Rezero0x00/Aero-Pendulum/Documentation/Hardware.jpeg

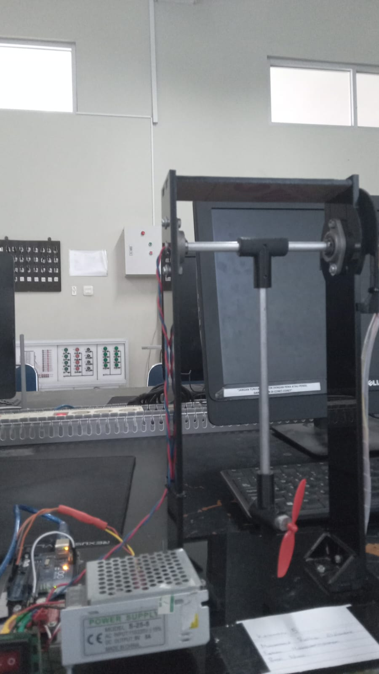
Documentation/Hardware.jpeg
