Rezero0x00/Aero-Pendulum/Documentation/3d-3.jpg

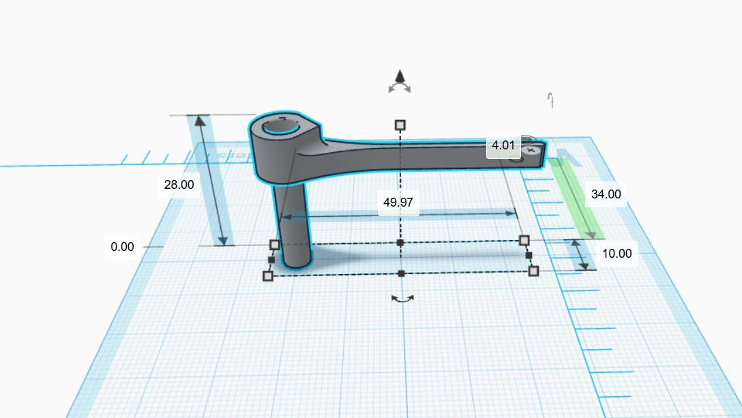
Documentation/3d-3.jpg
