Rezero0x00/Aero-Pendulum/Documentation/45.png

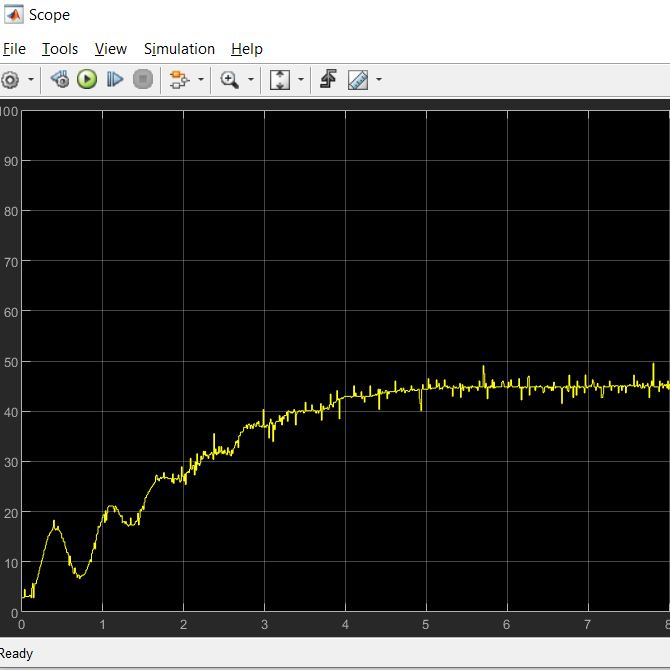
Documentation/45.png
