Rezero0x00/Aero-Pendulum/Documentation/60.png

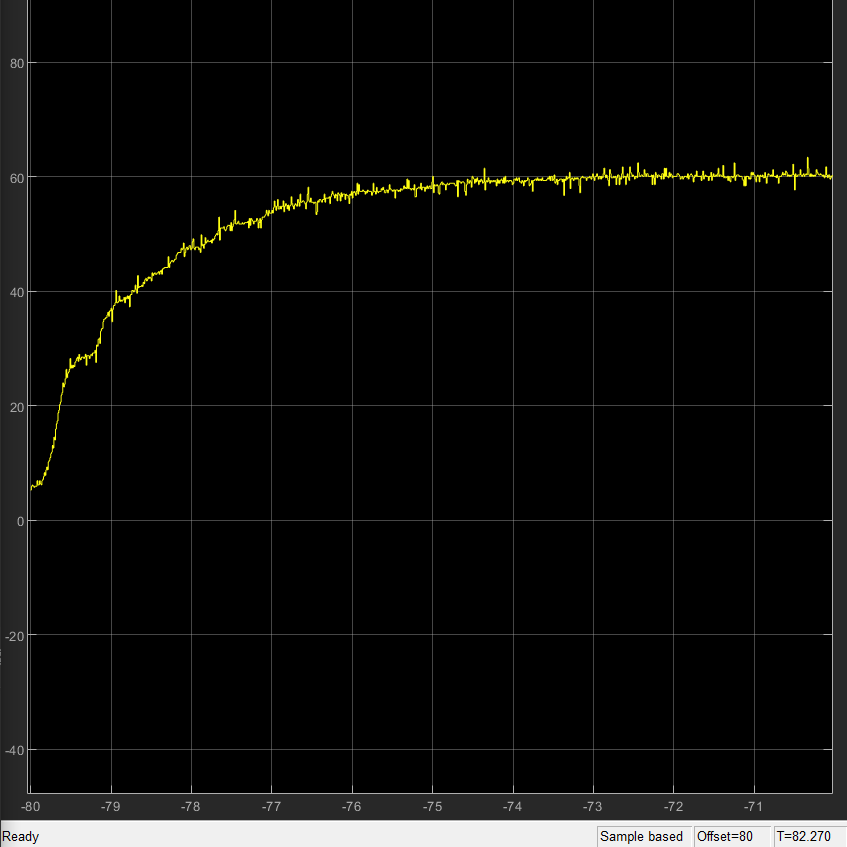
Documentation/60.png
