Rezero0x00/Aero-Pendulum/Documentation/block-diagram.png

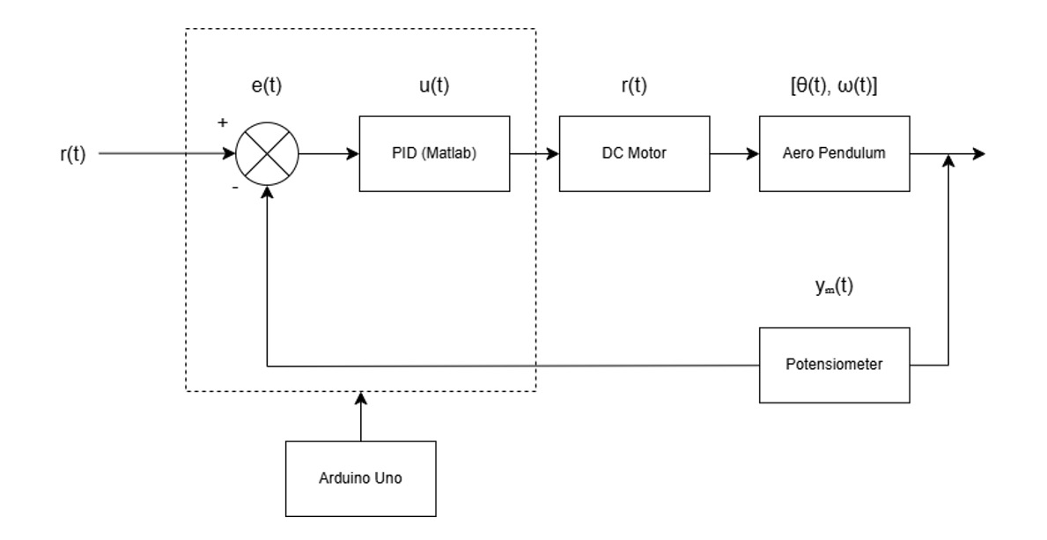
Documentation/block-diagram.png
