Rezero0x00/Aero-Pendulum/Documentation/demo (2).png

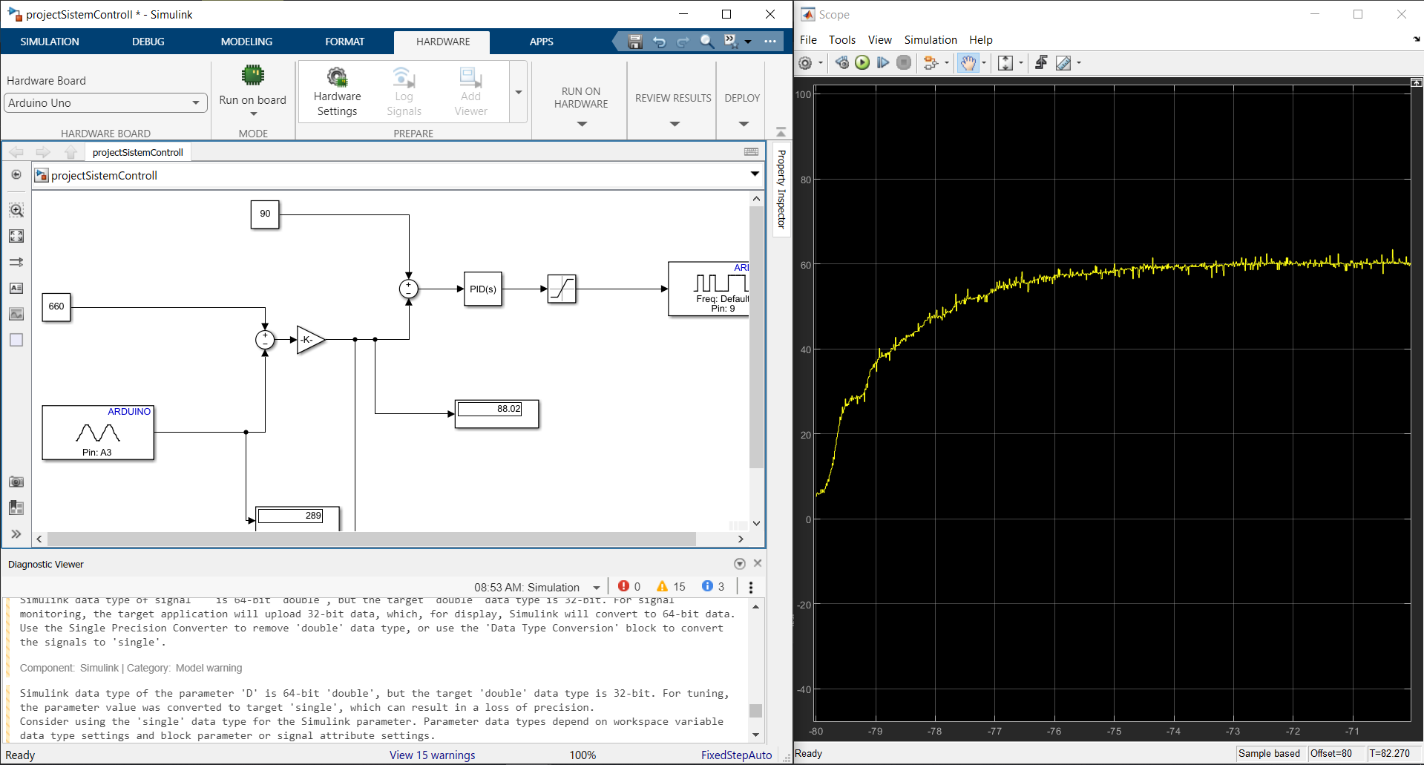
Documentation/demo (2).png
