Rezero0x00/Aero-Pendulum/Documentation/Demo.png

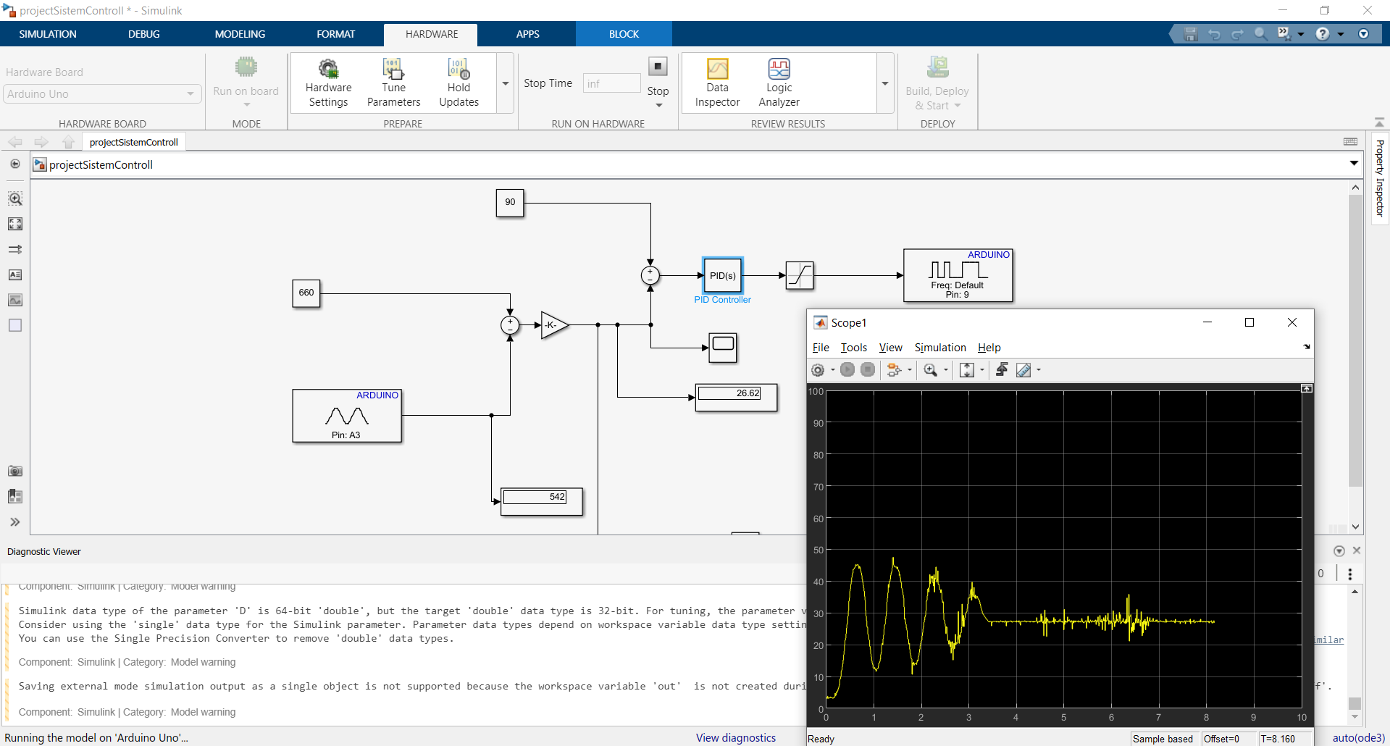
Documentation/Demo.png
