Rezero0x00/Aero-Pendulum/Documentation/disturbance.png

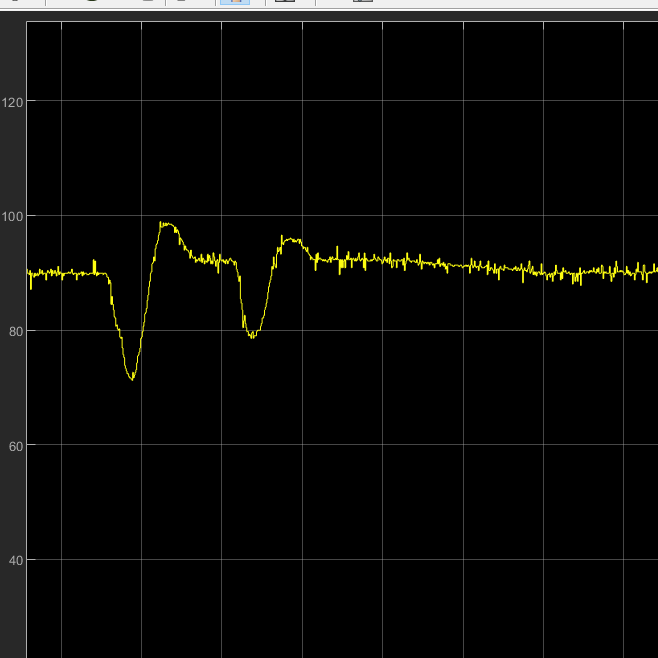
Documentation/disturbance.png
