Rezero0x00/Aero-Pendulum/Documentation/matlab.png

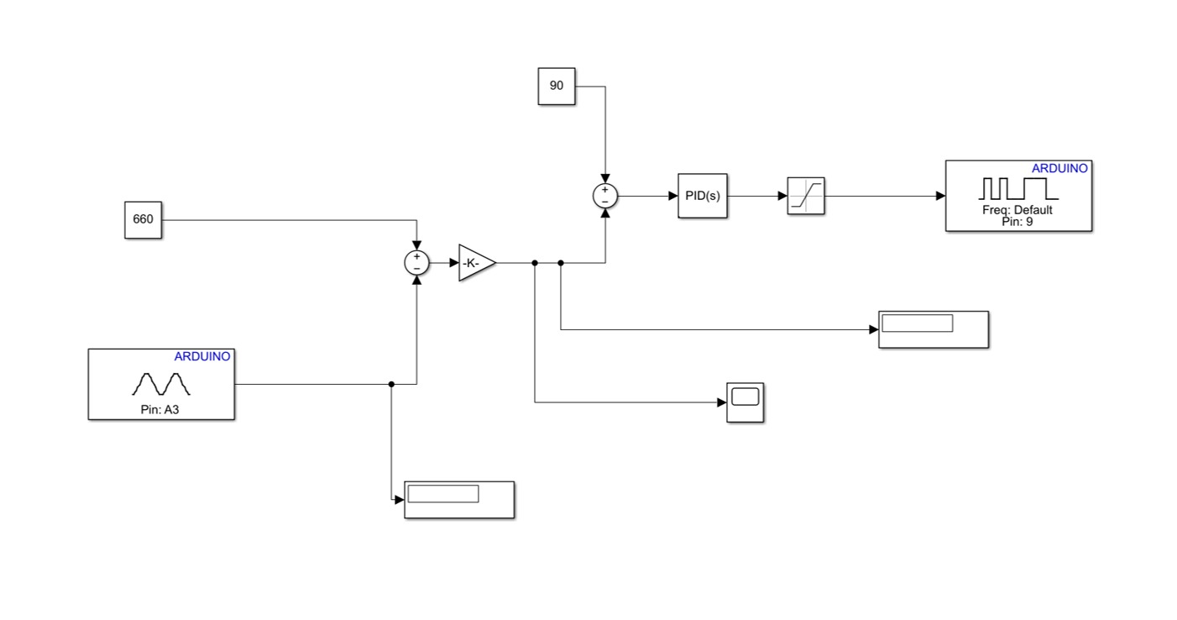
Documentation/matlab.png
