Rezero0x00/Aero-Pendulum/3d Models/part 2.stl

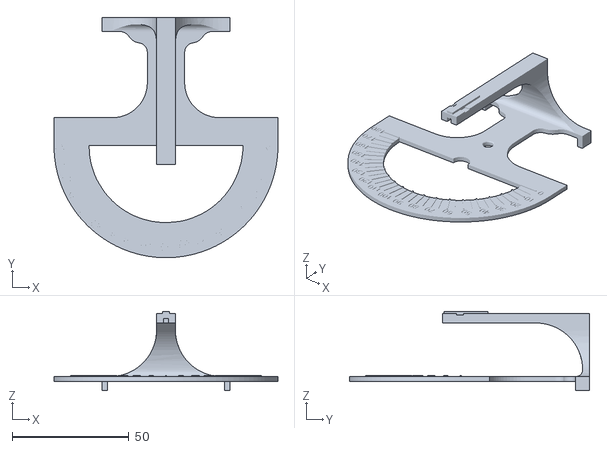
[picture p22: CAD file, 2026-08-08]
3d Models/part 2.stl
96.0 x 103.0 x 34.0
