Rezero0x00/Aero-Pendulum/3d Models/part 1.stl

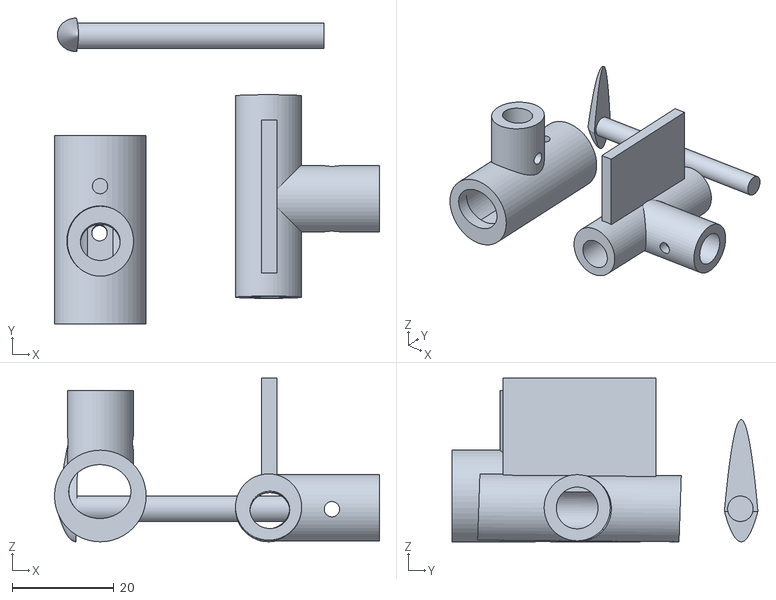
[picture p23: CAD file, 2026-08-08]
3d Models/part 1.stl
63.8 x 60.1 x 32.1
