Rezero0x00/Aero-Pendulum/3d Models/body.stl

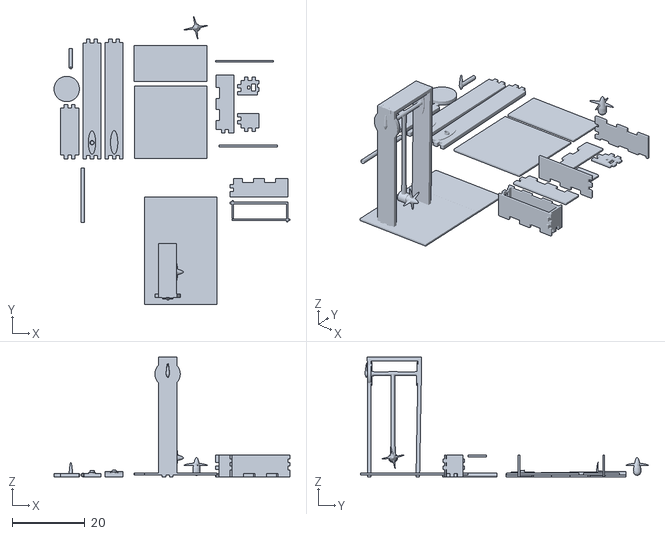
[picture p24: CAD file, 2026-08-08]
3d Models/body.stl
64.9 x 79.3 x 33.0
