Rezero0x00/Aero-Pendulum/Documentation/wiring.png

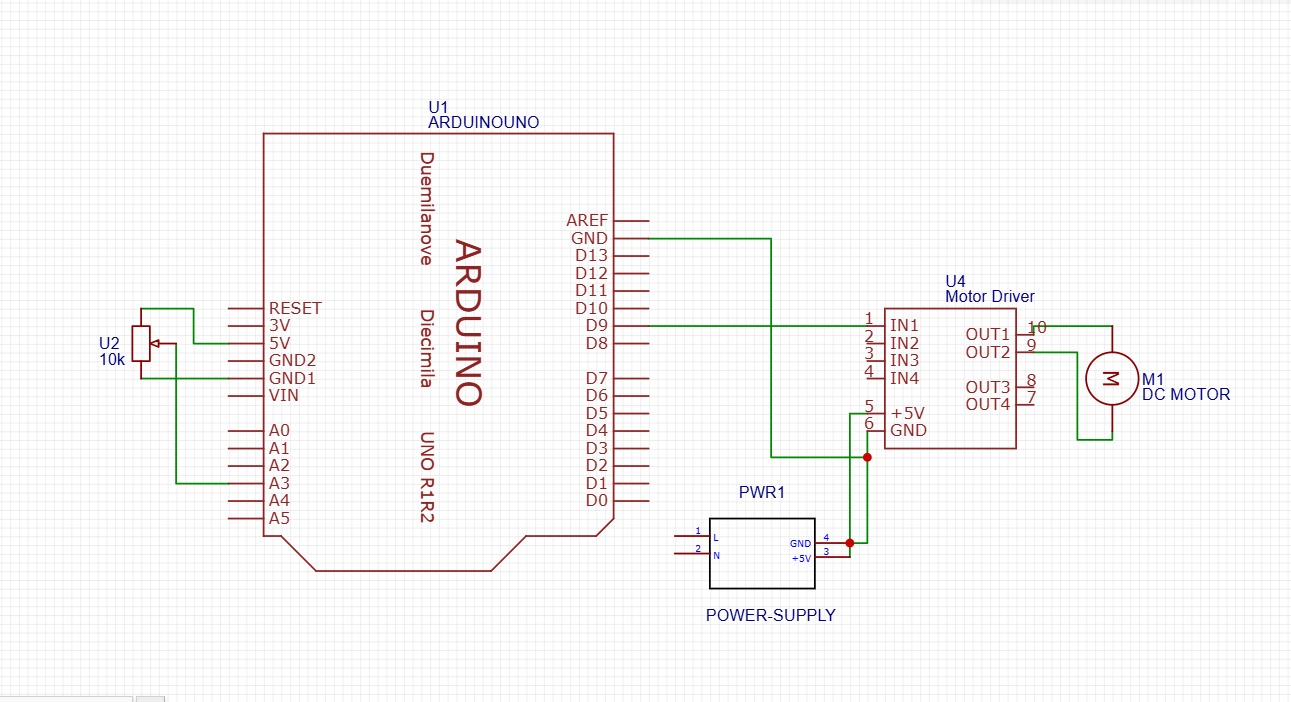
Documentation/wiring.png
